goodgoodhhh/optic/LED光通信说明.md

# STM32F103RCT6 可见光文字与语音通信

Keil 项目 Project.uvprojx。两端均使用 STM32F103RCT6，烧录相同固件，按键选择半双工收发方向。当前使用方法与编译说明见 [README](README.md)。

本次新增的是数字语音：音频电压 → ADC → 8 位 PCM → OOK 驱动 LED → 光电放大和比较器 → PCM → DAC → 独立功放 → 喇叭。手机播放人声也可作为音源。现有文字 HELLO 功能保留。

## 当前版本：方案二，激光模块 OUT 直接接 PA3

接收端已改为 TIM5 + DMA2 通道2采样 GPIO，软件反相后恢复 8N1；USART2 仅保留 PA2 发送。默认按有光时 OUT 为低电平的激光接收模块配置，不接额外硬件反相器。码率仍为 115200，文字与语音功能保留。详细接线与联调见 [激光模块方案二说明](接线图/激光模块-方案二接线说明.md)。

当前接线图：[激光直连总览](接线图/激光直连版-接线总览.png)、[音频与接口详图](接线图/激光直连版-音频接线.png)。

## 必须按新版引脚接线

| 用途 | 新版引脚 | 接法 |
|---|---|---|
| 音频输入 | PA1（A1） | 接经过衰减、隔直、1.65V 偏置、低通处理的音频；全程 0～3.3V |
| 发射控制 | PA2（A2） | 按配套厂家方法2，USART2 TX 直接接激光模块 S；不接外部三极管 |
| 光接收输入 | PA3（A3） | 激光接收 OUT 直接接入，0～3.3V，有光低/无光高 |
| 音频输出 | PA4（A4） | DAC，经低通、隔直接接收端功放的音频输入 |
| K1 / K2 / K3 / K4 | PB1 / PB0 / PA5 / PC0 | 外接按键，另一端接本机 GND |
| OLED SCL / SDA | PB8 / PB9 | OLED 使用 3.3V 逻辑 |
| 数字路径选择 | PB13 | 始终输出低；若没有选择电路可不接 |
| 可选文字接收指示 | PC13 | 低有效，不保证此板的板载灯接在 PC13 |

旧版 PB12 发射、PA0 接收和 PA4 按键接法已失效。PA4 现在是模拟输出，K4 必须移到 PC0。接线图文件夹里的旧“最终版”图片仅适用于历史 1000 bit/s 文字程序。

新版音频接线、电平调理见 [语音接线说明](接线图/文字与语音接线说明.md)。

## 按键操作

上电为 TEXT + LISTEN。

- K1：TEXT / VOICE 切换，停止之前的音频和发送队列。
- K2：SEND / LISTEN 切换，正在录制时也能切换。
- K3：TEXT+SEND 发送 HELLO；VOICE+SEND 开始连续采集，再按一次停止。
- K4：停止语音、回到文字模式并清空文字显示。
- 接收端选择 VOICE+LISTEN 后自动缓冲播放，不需要按 K3。

按键仍为非阻塞扫描：TIM2 每 1ms 调用 Key_Tick，内部每 20ms 读取，松手时产生键值。OLED 约每 100ms 刷新，音频采集和播放独立于主循环刷新。

文字内容在 User/main.c 的 hello 字符串中修改，最多 32 字节；当前字库仅支持 ASCII 文本。方向不符或队列满时发送函数返回 0，主循环不等待。

## 音频和传输参数

- 8kHz、8 位无符号 PCM、单声道；128 是静音中点。
- 每包 64 点，代表 8ms 音频，适合人声演示，不能按高保真音乐效果评价。
- USART2：115200 baud、8N1，每个比特约 8.68µs；1 亮、0 灭。SEND 空闲亮灯，LISTEN 本机灯灭。
- 语音包 71 字节，含起止位需 710bit；每秒 125 包，共 88750bit/s，低于 115200bit/s。
- 帧格式：A5 5A TYPE SEQ LEN PAYLOAD CRC_LO CRC_HI。
- TYPE=1：文字，LEN=1～32；TYPE=2：语音，LEN=64。
- CRC16-CCITT-FALSE：初值 FFFF，多项式 1021、不反射、无末异或；覆盖 TYPE、SEQ、LEN、PAYLOAD，校验低字节先发。
- 序号按 8 位循环，接收端统计可识别的跳号。CRC 错误丢包，不重传；暂时缺样本时输出静音中点，可能听到断续声。
- PA3 为普通 GPIO。默认 OOK_RX_INVERTED=1：有光时 PA3 低、无光时高，在恢复起始位/数据位/停止位前统一反相。若换回有光高的前端，改为 0。此宏现在作用于真实的逐位解码，不是给硬件串口接收的字节取反。
- 该协议与旧软件 OOK、PWM 版本不兼容，两块板必须一起更新。

PA2、PA3 之间只通过光链路传输，不需要把两板串口引脚用线相连。光接收前端需要能恢复 115200baud 方波；单纯接裸光敏二极管不能接收。旧 1000bit/s 前端是否足够快，必须用示波器确认。

## 外设分配与代码

| 资源 | 功能 |
|---|---|
| TIM2 | 1kHz 时间服务、按键、收帧/音频超时 |
| TIM3 TRGO | 8kHz 触发 ADC1_IN1 |
| ADC1 + DMA1 通道1 | 128 点循环缓冲，半满/全满时各处理 64 点 |
| USART2 + DMA1 通道7 | 非阻塞发送文字或语音包，4 槽队列最多保存 3 包 |
| TIM5 更新事件 + DMA2 通道2 | 四倍采样 GPIOA->IDR，取 PA3 并反相，软件恢复 8N1，再收帧/CRC/投递 |
| TIM6 TRGO + DAC1 + DMA2 通道3 | 8kHz 播放，128 点循环缓冲 |
| 512 字节接收环形缓冲 | 先收到 3 包再启动播放，超过 100ms 无有效语音则停止 |

Hardware/Voice.c、Voice.h：音频 ADC/DAC、DMA 中断、缓冲、启停和统计。
Hardware/OOK.c、OOK.h：USART2 发送队列、TIM5/DMA GPIO 采样、软件 8N1 解码、帧解析、CRC、文字消息缓存。
User/main.c：模式、方向、按键及 OLED。
Hardware/Key.c：K4 改为 PC0，原扫描方式保留。

接收采样 DMA2 通道2抢占优先级最高，其后 DAC DMA、ADC/TX DMA、TIM2。共享队列和启停使用保存/恢复 PRIMASK 的短临界区，ISR 不等待数据、不分配堆内存。启动文件栈空间从 1KiB 增至 2KiB，为显示调用和中断嵌套留余量。GPIO 采样 TIM5 按 USART2 实际 BRR 和 PCLK1 倍频关系推导周期；当前 TIM5 ARR=155，采样约 461538 次/秒，半区 512 点约 1.11ms。1024 点循环采样区与 512 点静态快照区合计 3072 字节；复制期间确认半区未覆盖，再从快照解码。若错过处理期限，计数 rx_overruns、丢弃残帧并重新同步。音频定时器仍按 72MHz 配置，改系统时钟时要同步调整。

OLED 的 IN:ON 表示正在采集，IN:ERR 表示 ADC 校准失败；LV 是最近 64 点的 ADC 峰峰值。接收时 RX 是累计有效语音包数，CRC 是累计校验错误，GAP 是累计可识别的序号缺口。文字界面增加 FE（软件 8N1 起始/停止位错误）和 OV（采样缓冲覆盖）计数。更多 rx_dma_errors、tx_drops、rx_drops、underruns、dma_errors 可在调试器中查看 audio_stats / link_stats 或调用统计接口。

## 两板操作顺序

1. 先接新 PA2/PA3 光链路，两端 TEXT，发送端 K2 到 SEND、K3 发 HELLO；接收端保持 LISTEN，确认 OLED 显示 HELLO。
2. 先把手机/LM386 输出调理好，测 PA1：静音约 1.65V；播放人声时波形不触及 0V/3.3V，初调可控制在约 1Vpp。未满足前不要连接 PA1。
3. 接收端 PA4 通过隔直、低通接功放音频输入，功放音量先最小；功放喇叭端接喇叭。
4. 两端按 K1 到 VOICE，接收端保持 LISTEN；发送端保持 SEND，按 K3 开始。手机播放人声，发送端 IN:ON、LV 随音频变化，接收端 RX 持续增加并出现 PLAY:ON。
5. 发送端再按 K3 停止。接收端最多约 100ms 无有效语音后停止播放；K4 停止并回到 TEXT。
6. 出现断续声先看 CRC/GAP，检查光路与比较器极性/带宽；LV 很小检查音源，LV 接近 4095 检查输入削顶和幅度。

独立供电时两板无需互接 GND；每块板与自己的 LED 驱动、模拟前端、功放必须共地。

## 编译及实际验证边界

本次软件接收版的完整重编译结果见 Objects/SoftwareRx-build.log，最终资源统计见本节编译记录。生成 Objects/Project.axf，可在 Keil 下载；未自动烧录开发板。

尚未进行实物音频、模拟电平、光链路误码率和连续播放验证。采样/播放两端晶振存在偏差，缓冲会在较长时间后产生积累偏移；当前缺样本补静音、溢出丢包，没有自适应重采样。当前无压缩、纠错、确认重传或双向同时通话。

外设依据：[ST RM0008](https://www.st.com/resource/en/reference_manual/rm0008-stm32f103xx-advanced-armbased-32bit-mcus-stmicroelectronics.pdf)。LM386 电气特性依据：[TI LM386 数据手册](https://www.ti.com/lit/ds/symlink/lm386.pdf)。

最终完整重编译：Keil ARMCC V5.06 update 5，0 错误、0 警告。Code=17456、RO-data=3308、RW-data=84、ZI-data=8252 字节，Flash 内容约 20.4KiB，静态 RAM 与栈/堆预留合计约 8.1KiB。
