goodgoodhhh/optic/接线图/用户开发板背面-原图.png

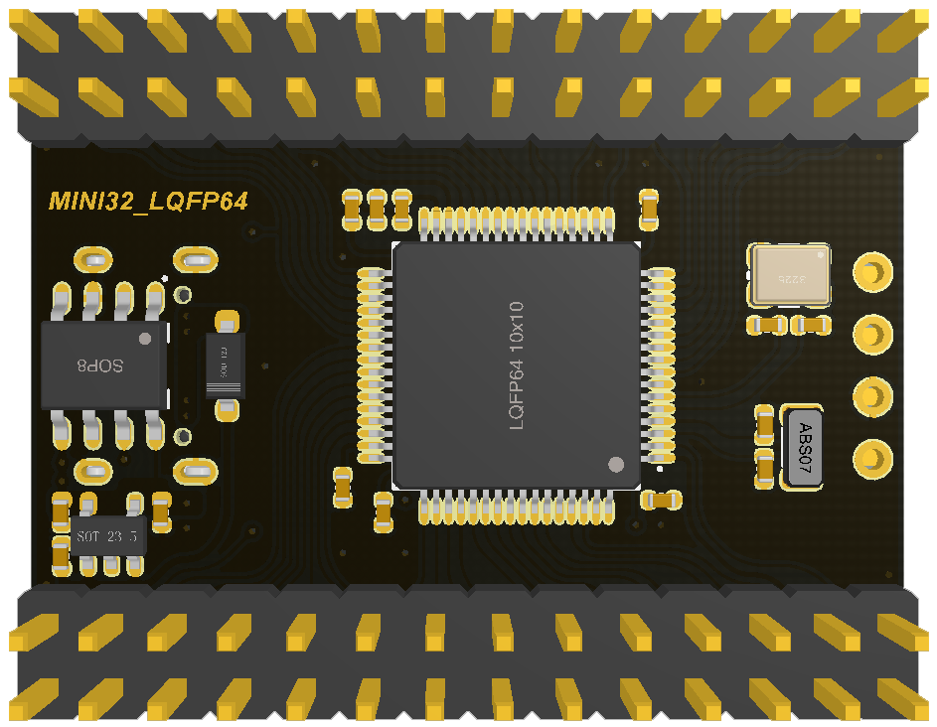
接线图/用户开发板背面-原图.png
