goodgoodhhh/optic/接线图/语音接线-总览.png

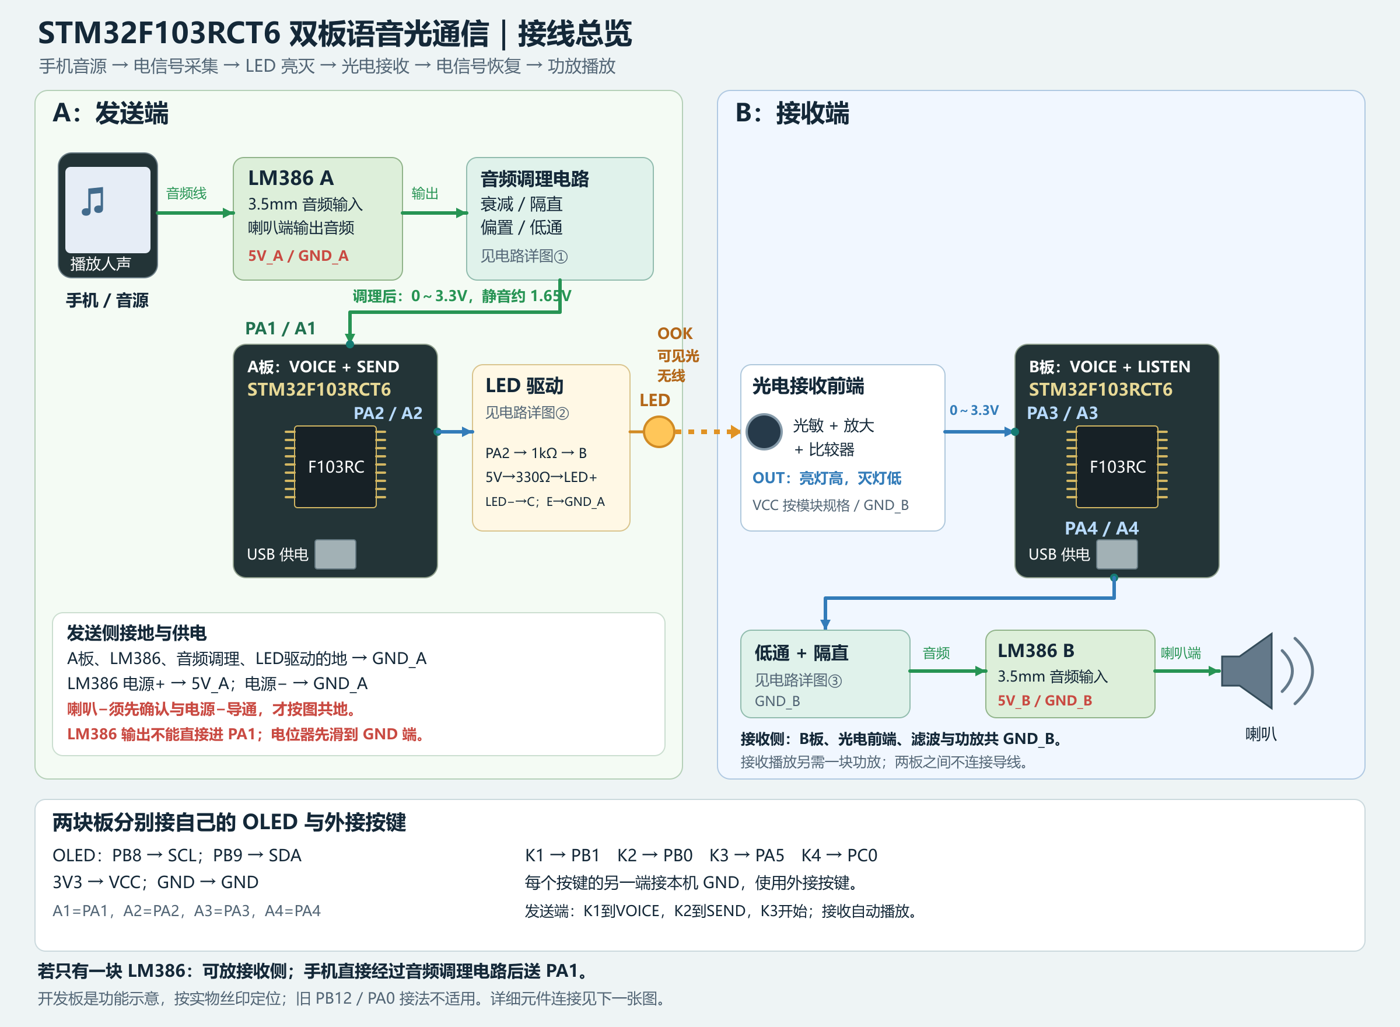
接线图/语音接线-总览.png
