goodgoodhhh/optic/接线图/语音接线-电路详图.png

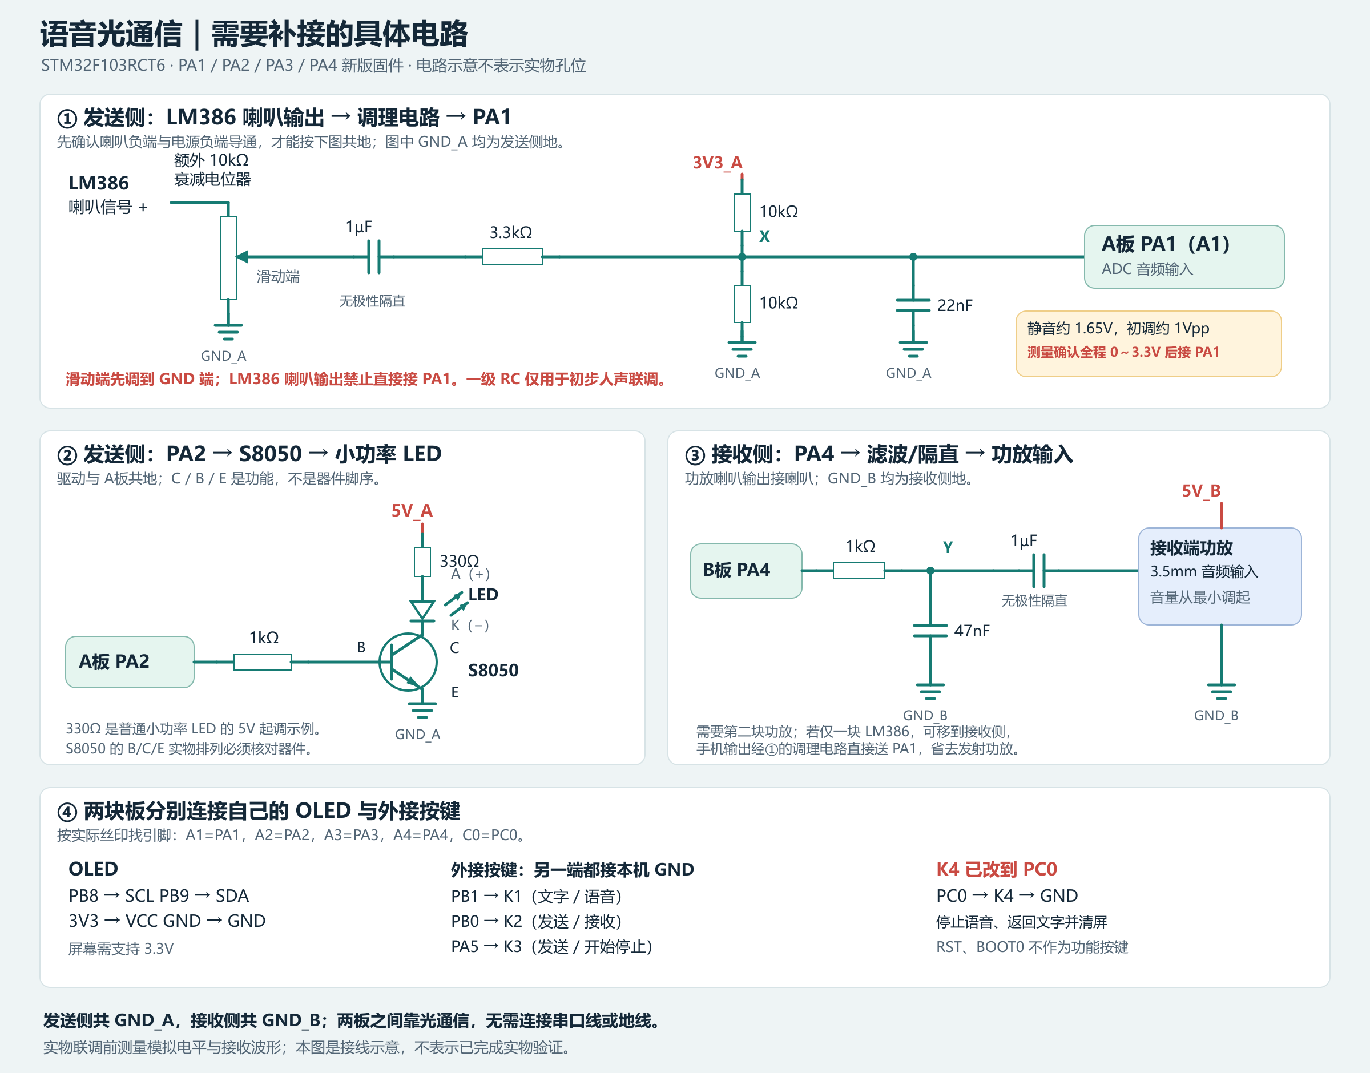
接线图/语音接线-电路详图.png
